Even-lwx/ai8051-esc/SEEKFREE_AI8051U_BLDC/bldc/bldc_version.txt

V2.0.5
	(2026-06-25) 屏蔽掉debug串口，已经串口中断，防止编译报错
	
V2.0.4
	(2026-05-27) 降低频率(40Mhz->35Mhz)
	
V2.0.3
	(2026-05-11) 新增 BLDC_USR_DUTY：可选宏固定占空比，默认 0 仍为外部 PWM 捕获

V2.0.2
	(2026-03-31) PWM频率(48Khz->43.333Khz)，解决干扰20Khz电磁信号源的问题
	
V2.0.1
	(2026-03-25) 增加电调稳定性
	
V2.0.0
	(2026-01-09) 移植STC32G电调代码
