Even-lwx/ai8051-esc/Resource/11.png

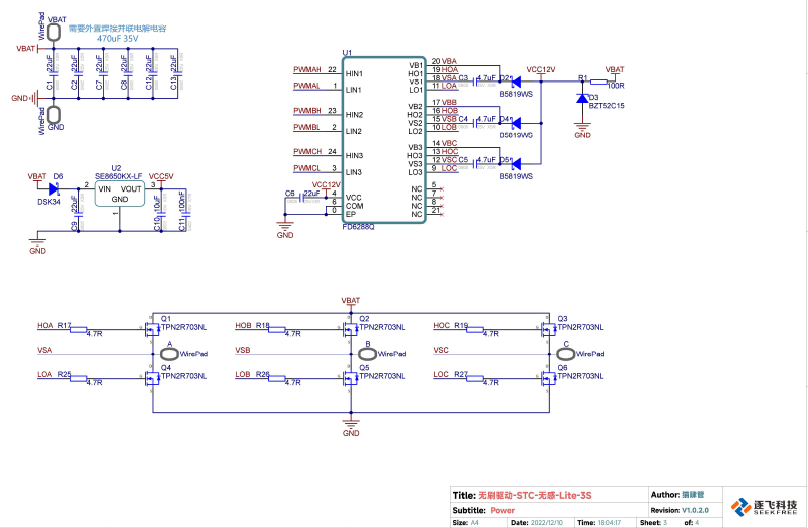
Resource/11.png
