Even-lwx/ai8051-esc/Resource/12.png

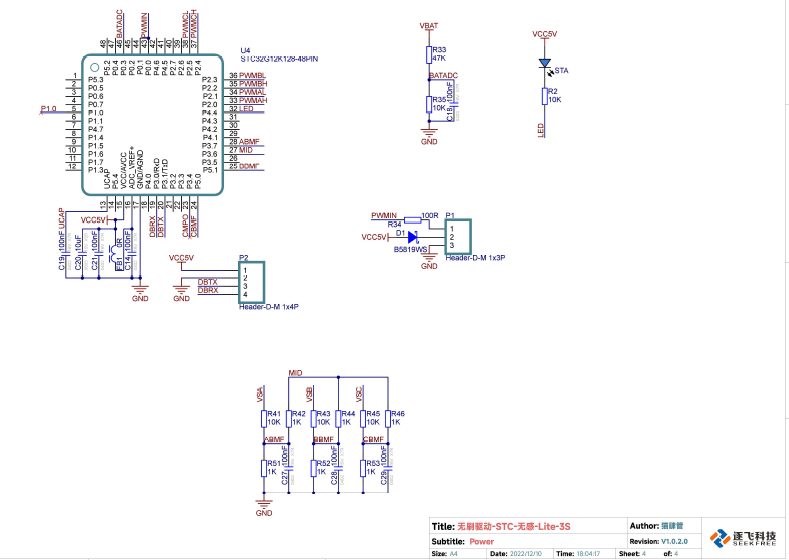
Resource/12.png
