Even-lwx/ai8051-esc/Resource/14.png

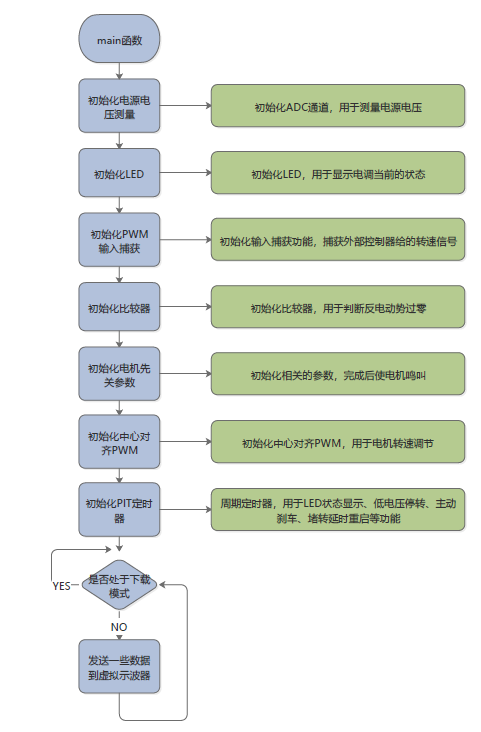
Resource/14.png
