Even-lwx/ai8051-esc/Resource/15.png

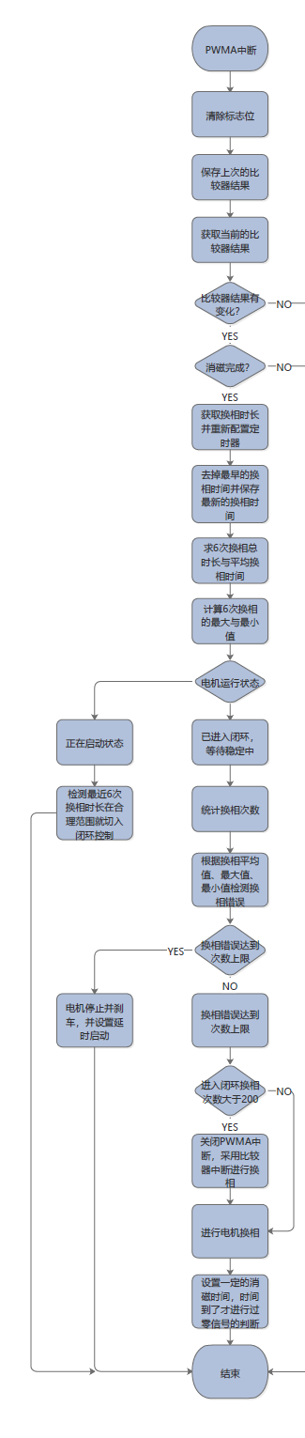
Resource/15.png
