Even-lwx/ai8051-esc/Resource/16.png

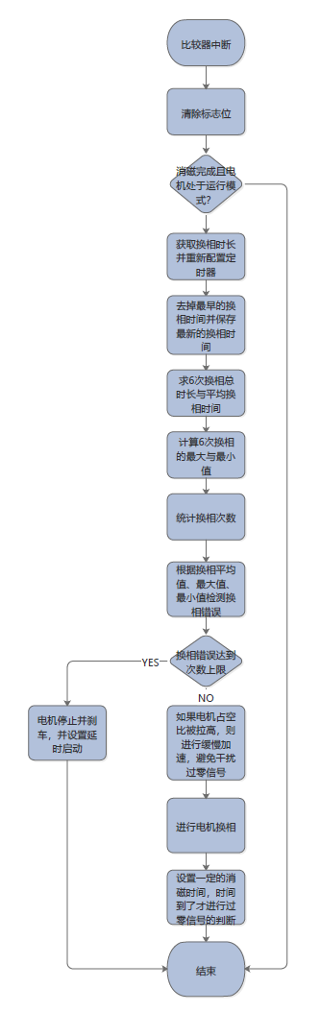
Resource/16.png
