Even-lwx/ai8051-esc/Resource/17.png

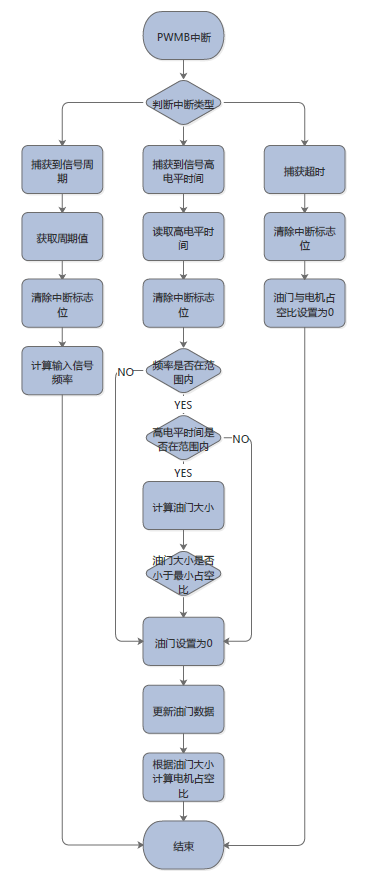
Resource/17.png
