Even-lwx/ai8051-esc/Resource/18.png

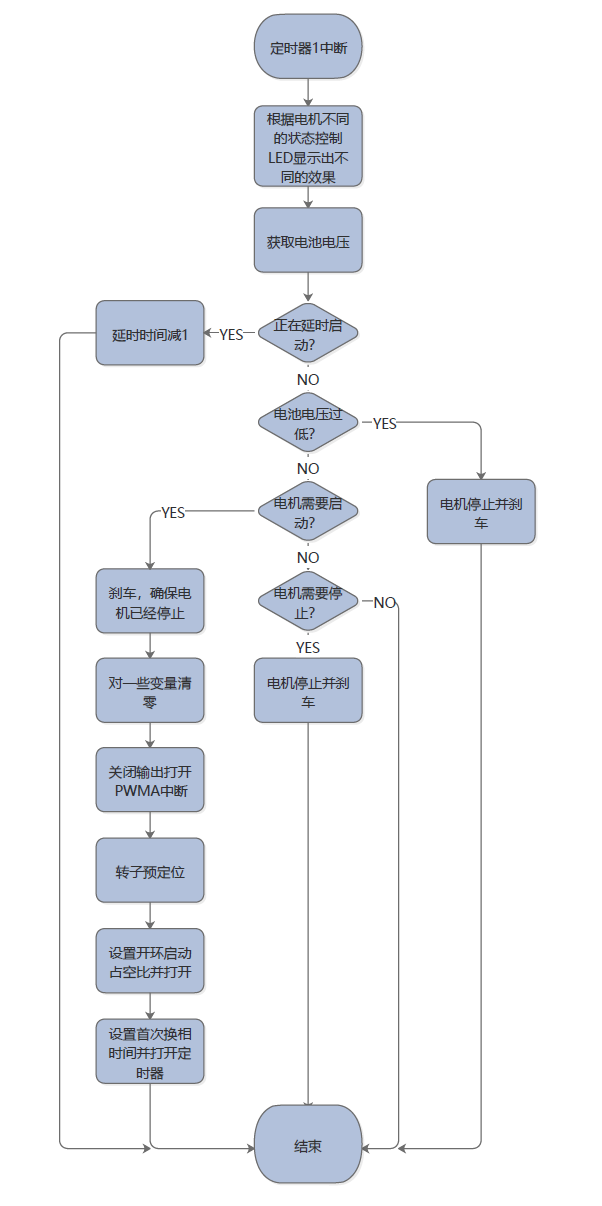
Resource/18.png
