Even-lwx/ai8051-esc/Resource/19.png

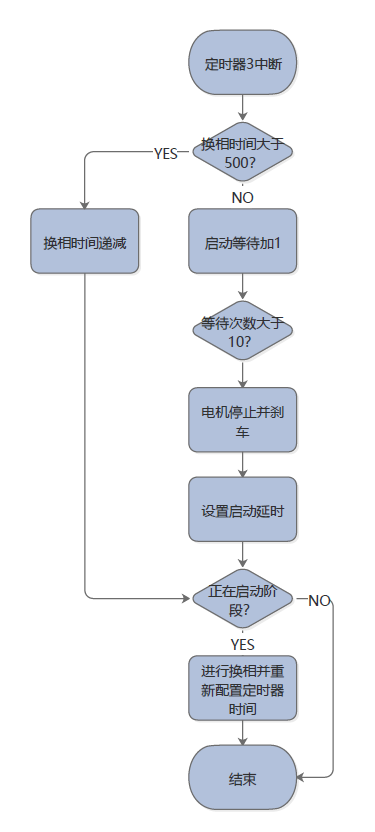
Resource/19.png
