Even-lwx/ai8051-esc/Resource/20.png

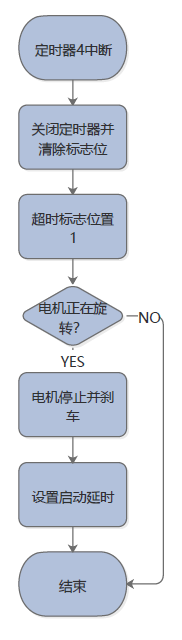
Resource/20.png
