Even-lwx/ai8051-esc/Resource/21.png

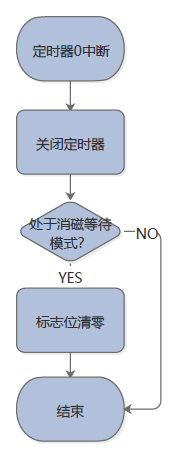
Resource/21.png
