Even-lwx/ai8051-esc/Resource/clip_image002.jpg

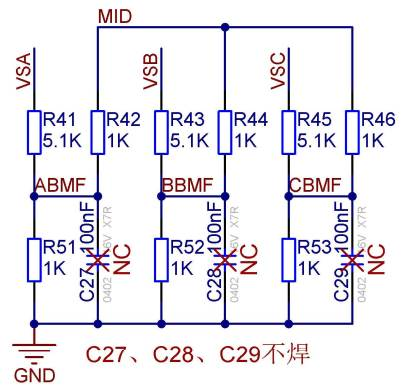
Resource/clip_image002.jpg
