Even-lwx/ai8051-esc/Resource/e8ea1624100522ad72529c74d20f11d.png

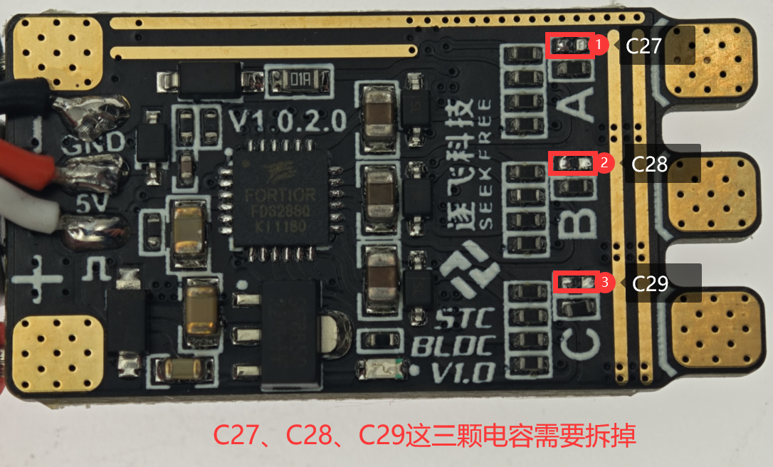
Resource/e8ea1624100522ad72529c74d20f11d.png
