Even-lwx/ai8051-esc/Resource/image-20250102145758415.png

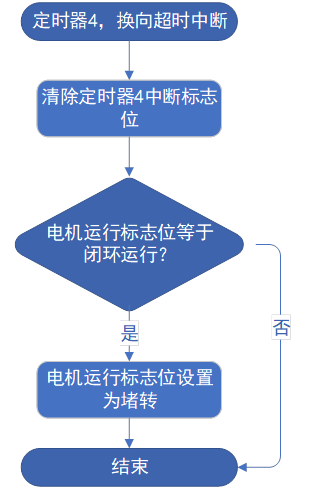
Resource/image-20250102145758415.png
