Even-lwx/ai8051-esc/Resource/image-20250102150058315.png

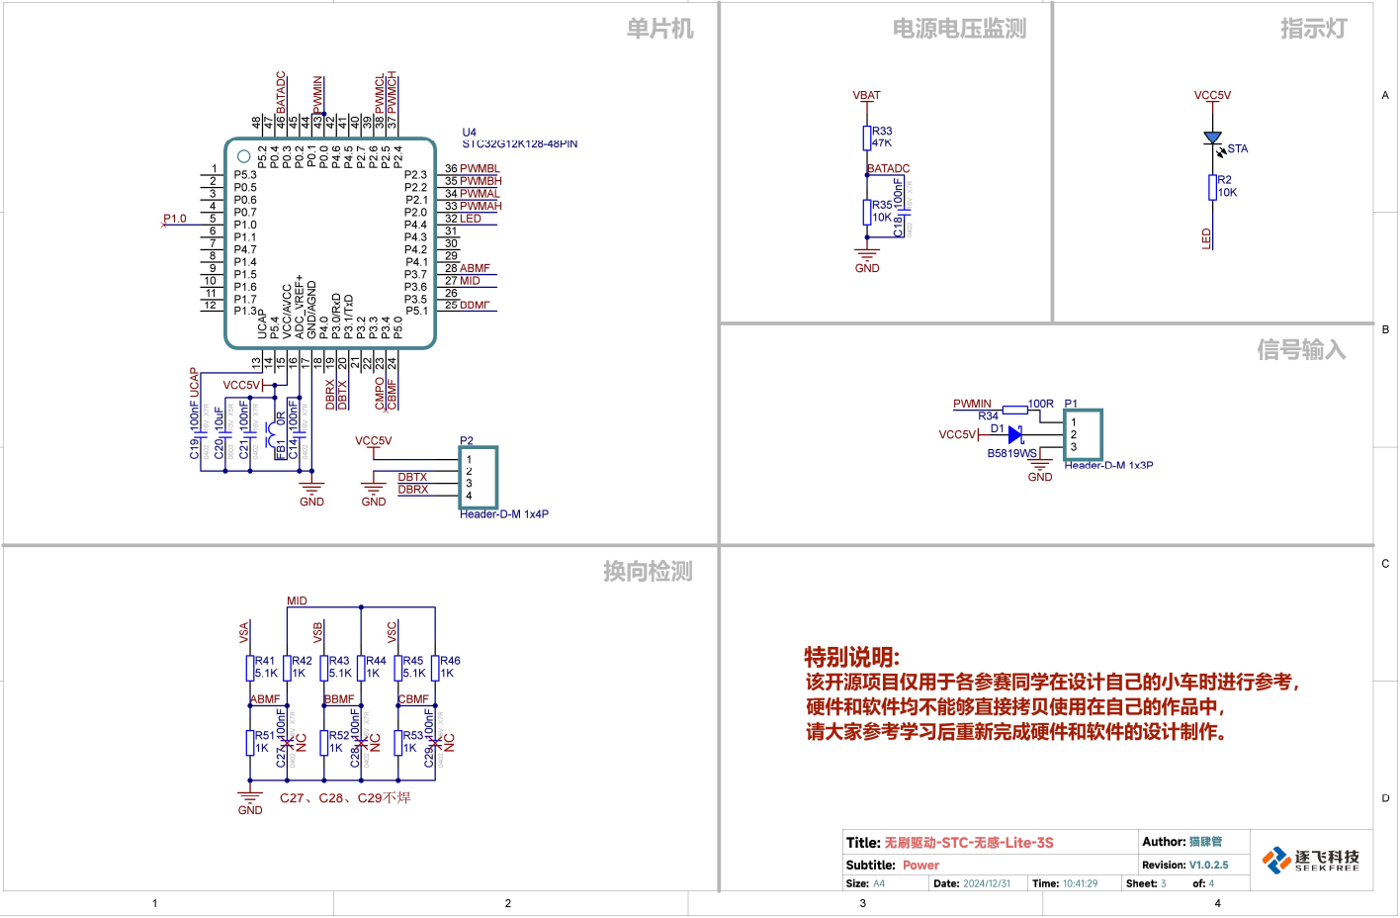
Resource/image-20250102150058315.png
