Even-lwx/ai8051-esc/Resource/image-20250102150125310.png

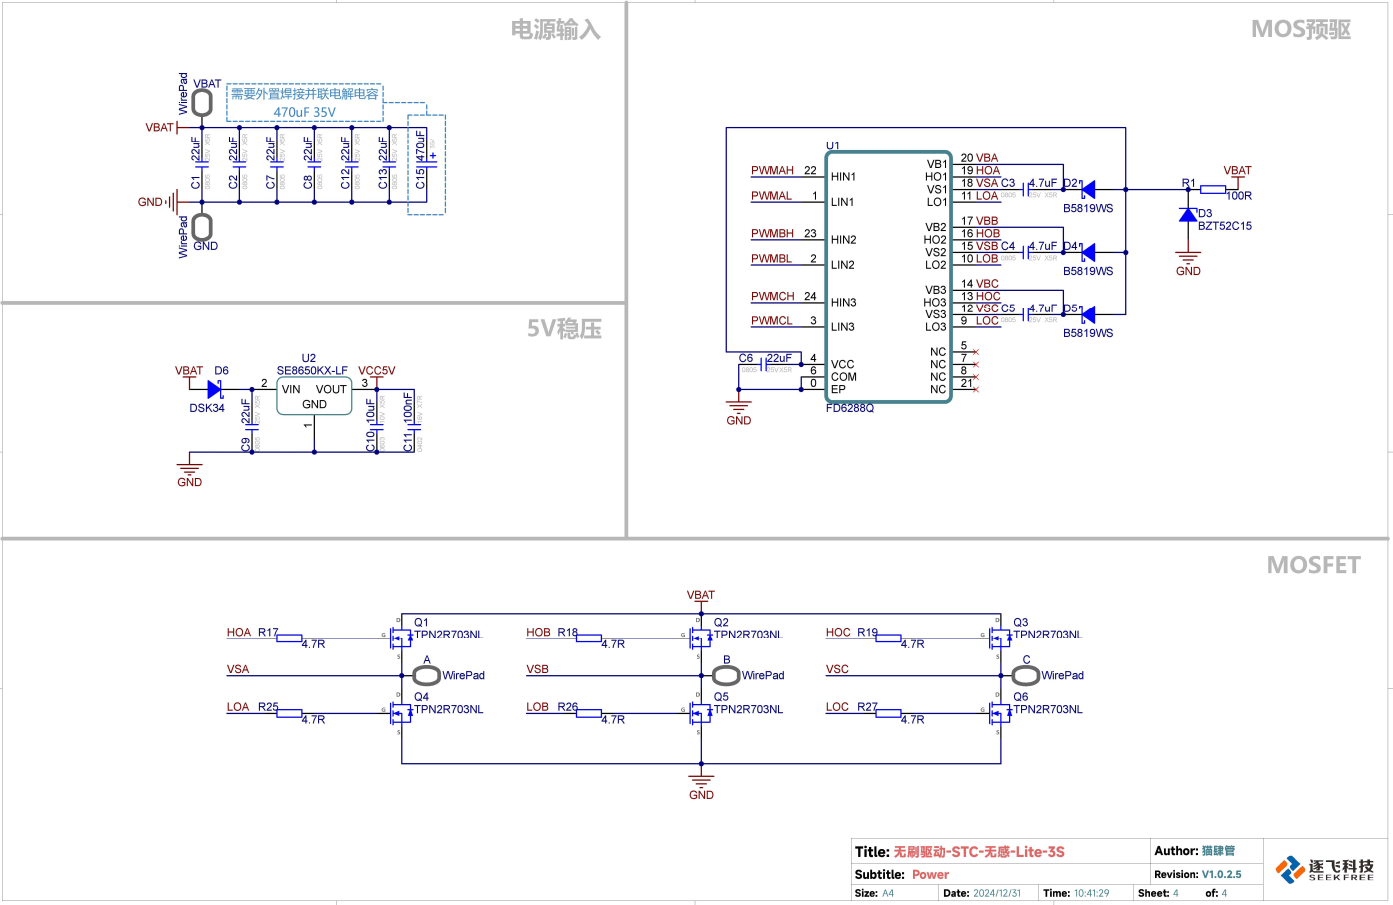
Resource/image-20250102150125310.png
