Even-lwx/ai8051-esc/【文档】说明书 芯片手册 原理图 位号图等/无刷驱动-STC-无感-Lite3S_丝印图 背面_V2.0.2.0.png

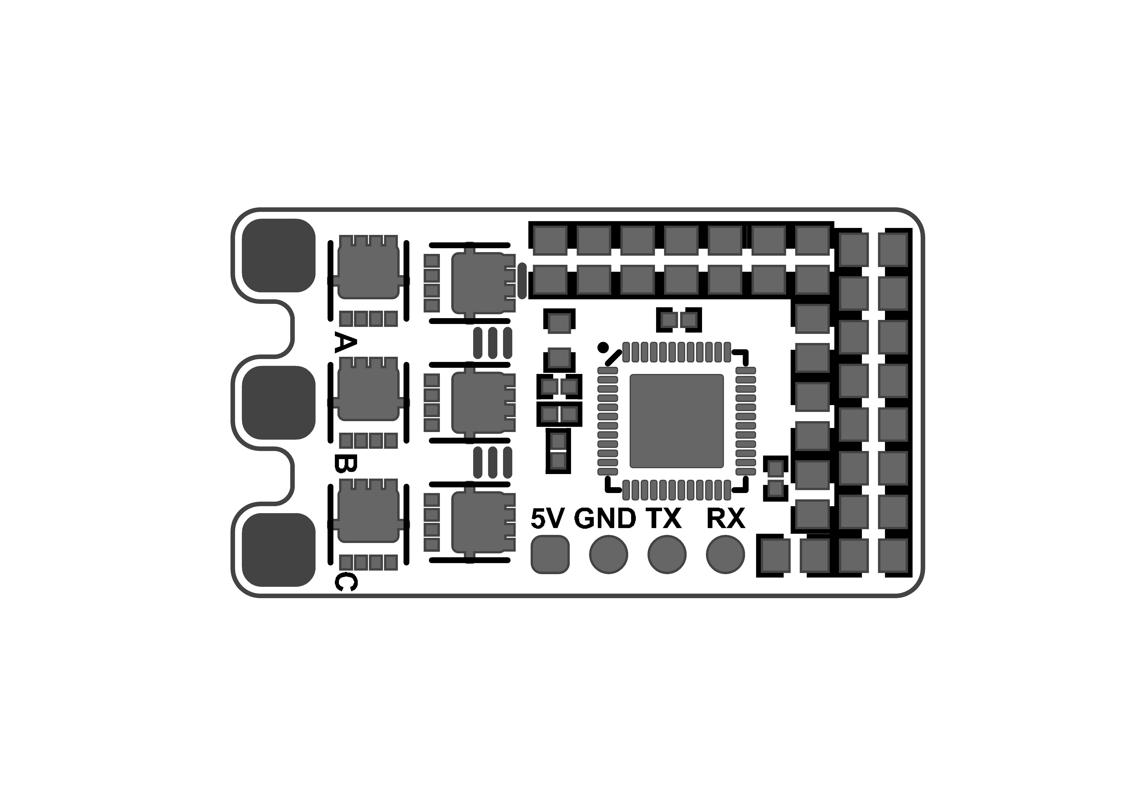
【文档】说明书 芯片手册 原理图 位号图等/无刷驱动-STC-无感-Lite3S_丝印图 背面_V2.0.2.0.png
