Even-lwx/ai8051-esc/已编译好的固件/【必看】下载注意事项.png

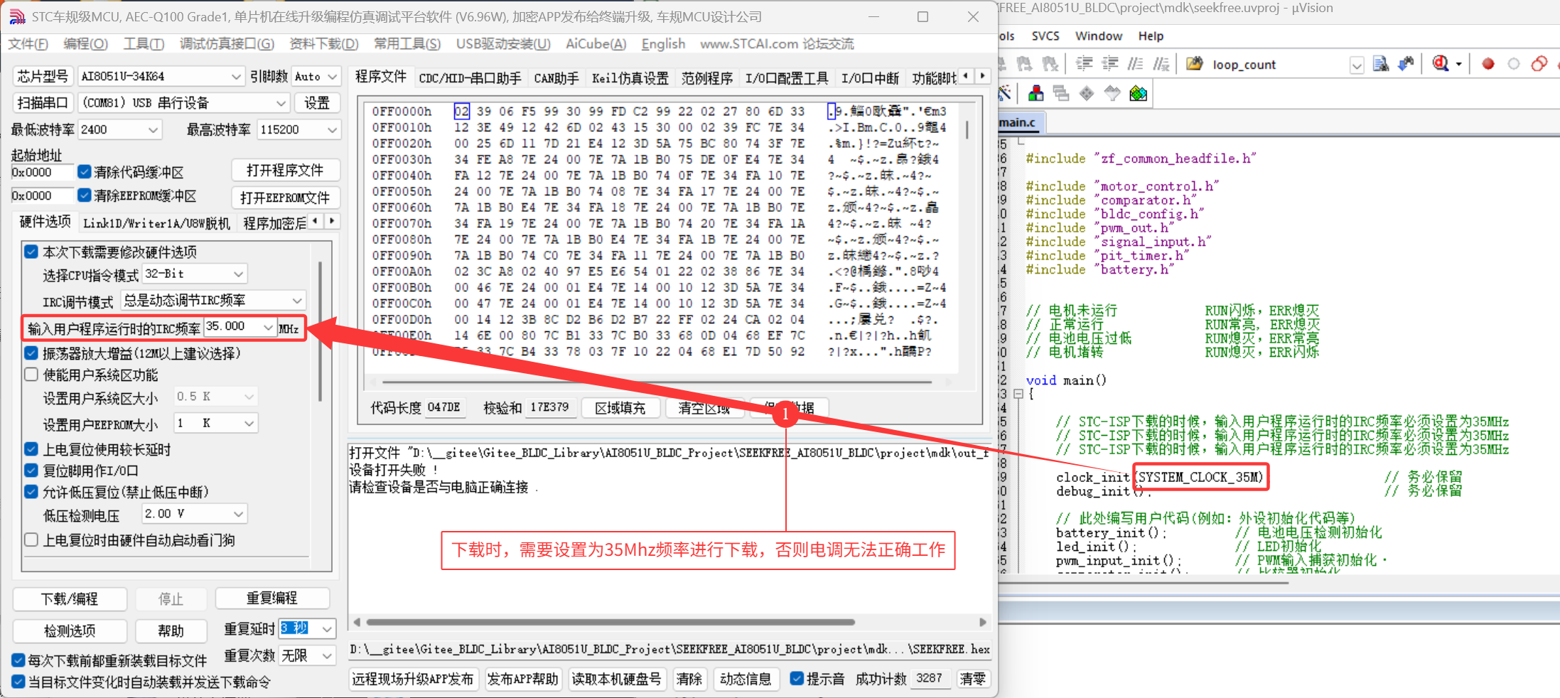
已编译好的固件/【必看】下载注意事项.png
