Even-lwx/ai8051-esc/【文档】说明书 芯片手册 原理图 位号图等/无刷驱动-STC-无感-Lite3S_原理图_V2.0.2.0.pdf

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
无刷驱动-STC-无感-Lite-3S | 贝果
| V2.0.2.0
2026/3/4 | 18:33:26
Title: | Author:

Date:

Revision:
Size: A4 | Time: | Sheet: | of:

### Subtitle: Revision

版本号 | 修订日期 | 修订记录

在此文件中，仅以版本号前两位(发行版)，划分版本之间的区别。

版权所有，保留一切权利。
本公司致力于产品的不断改善和功能升级，内容如有改动，恕不另行通知。
V2.0.0.0 | 2026-01-20 | 芯片改为AI8051U；
| | 改变下载口封装。
| 2026-01-20
| | AI8051U输出的PWM信号接入六个0R电阻到预驱。

添加足够多的贴片电容，不再外接电容；

V1.0.0.0 | 2022-11-13 | 初始版本。
V1.0.1.0 | 2022-11-26 | 删除不必要的逻辑，PWM输入采集换引脚。
V1.0.2.0 | 2022-12-06 | 增加LED，删除测试点，增大焊盘。
V1.0.2.1 | 2023-02-27 | 修改预驱供电网络标号。
V1.0.2.2 | 2024-01-18 | 修改外置的电容符号。
V1.0.2.3 | 2024-03-03 | 修改电容编号小BUG。
V1.0.2.4 | 2024-03-19 | 修改电容编号小BUG。
V1.0.2.5 | 2024-12-31 | 修改采样滤波电容。

V2.0.1.0
修改AI8051U输出的PWM信号引脚；

修改SE8650封装；

V2.0.2.0 | 2026-02-27
删除PWM信号引脚的六个0R电阻。

PWM捕获引脚添加下拉电阻；

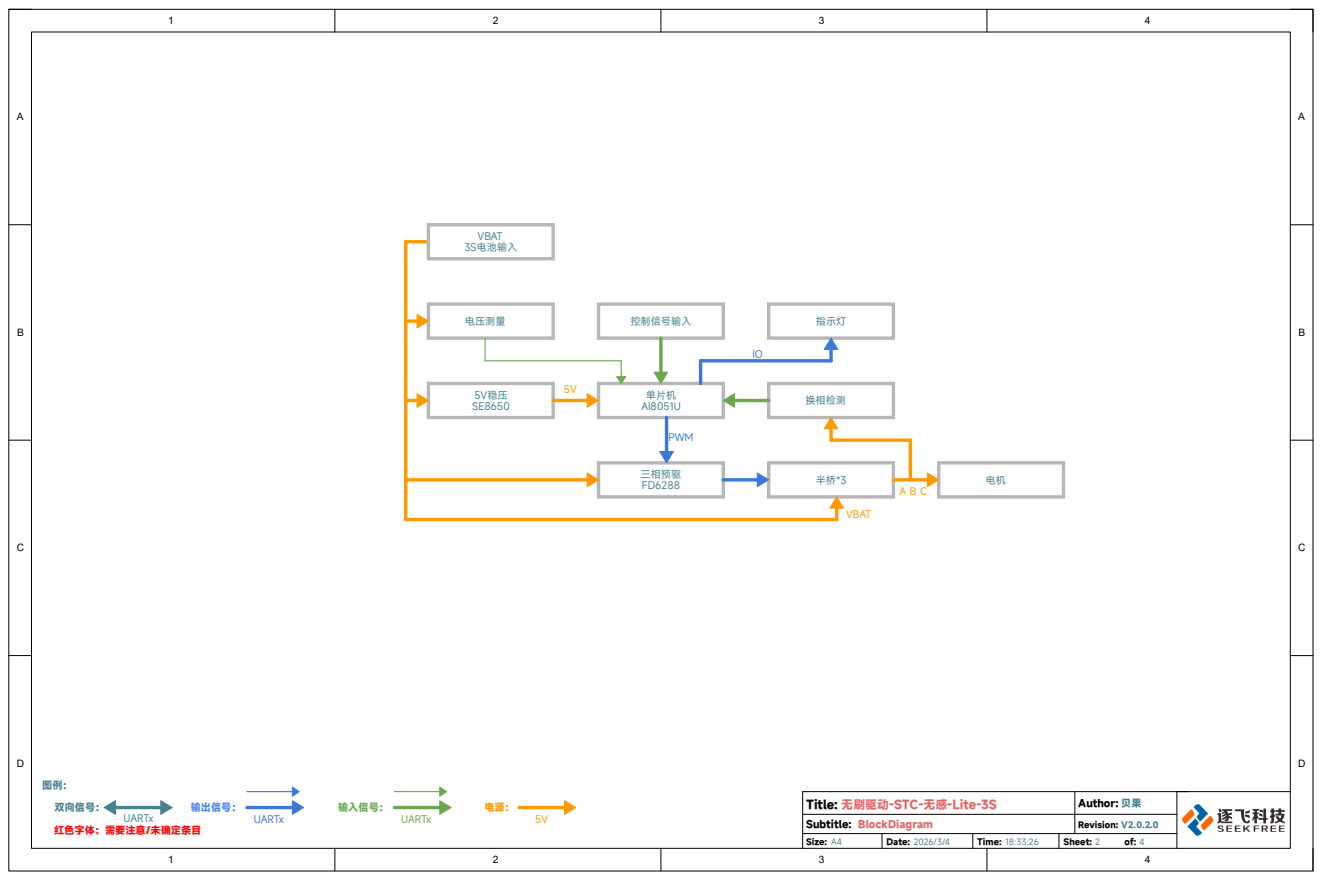
[picture p63: page 2]
无刷驱动-STC-无感-Lite-3S; Title:; Author:; Revision:; Subtitle: BlockDiagram; 双向信号：; 输出信号：; 输入信号：; 红色字体：需要注意/未确定条目; UARTx; 电压测量; 5V稳压; 三相预驱; 单片机; 换相检测; 控制信号输入; PWM; VBAT; VBAT 3S电池输入; 指示灯

电源接口 | 预驱

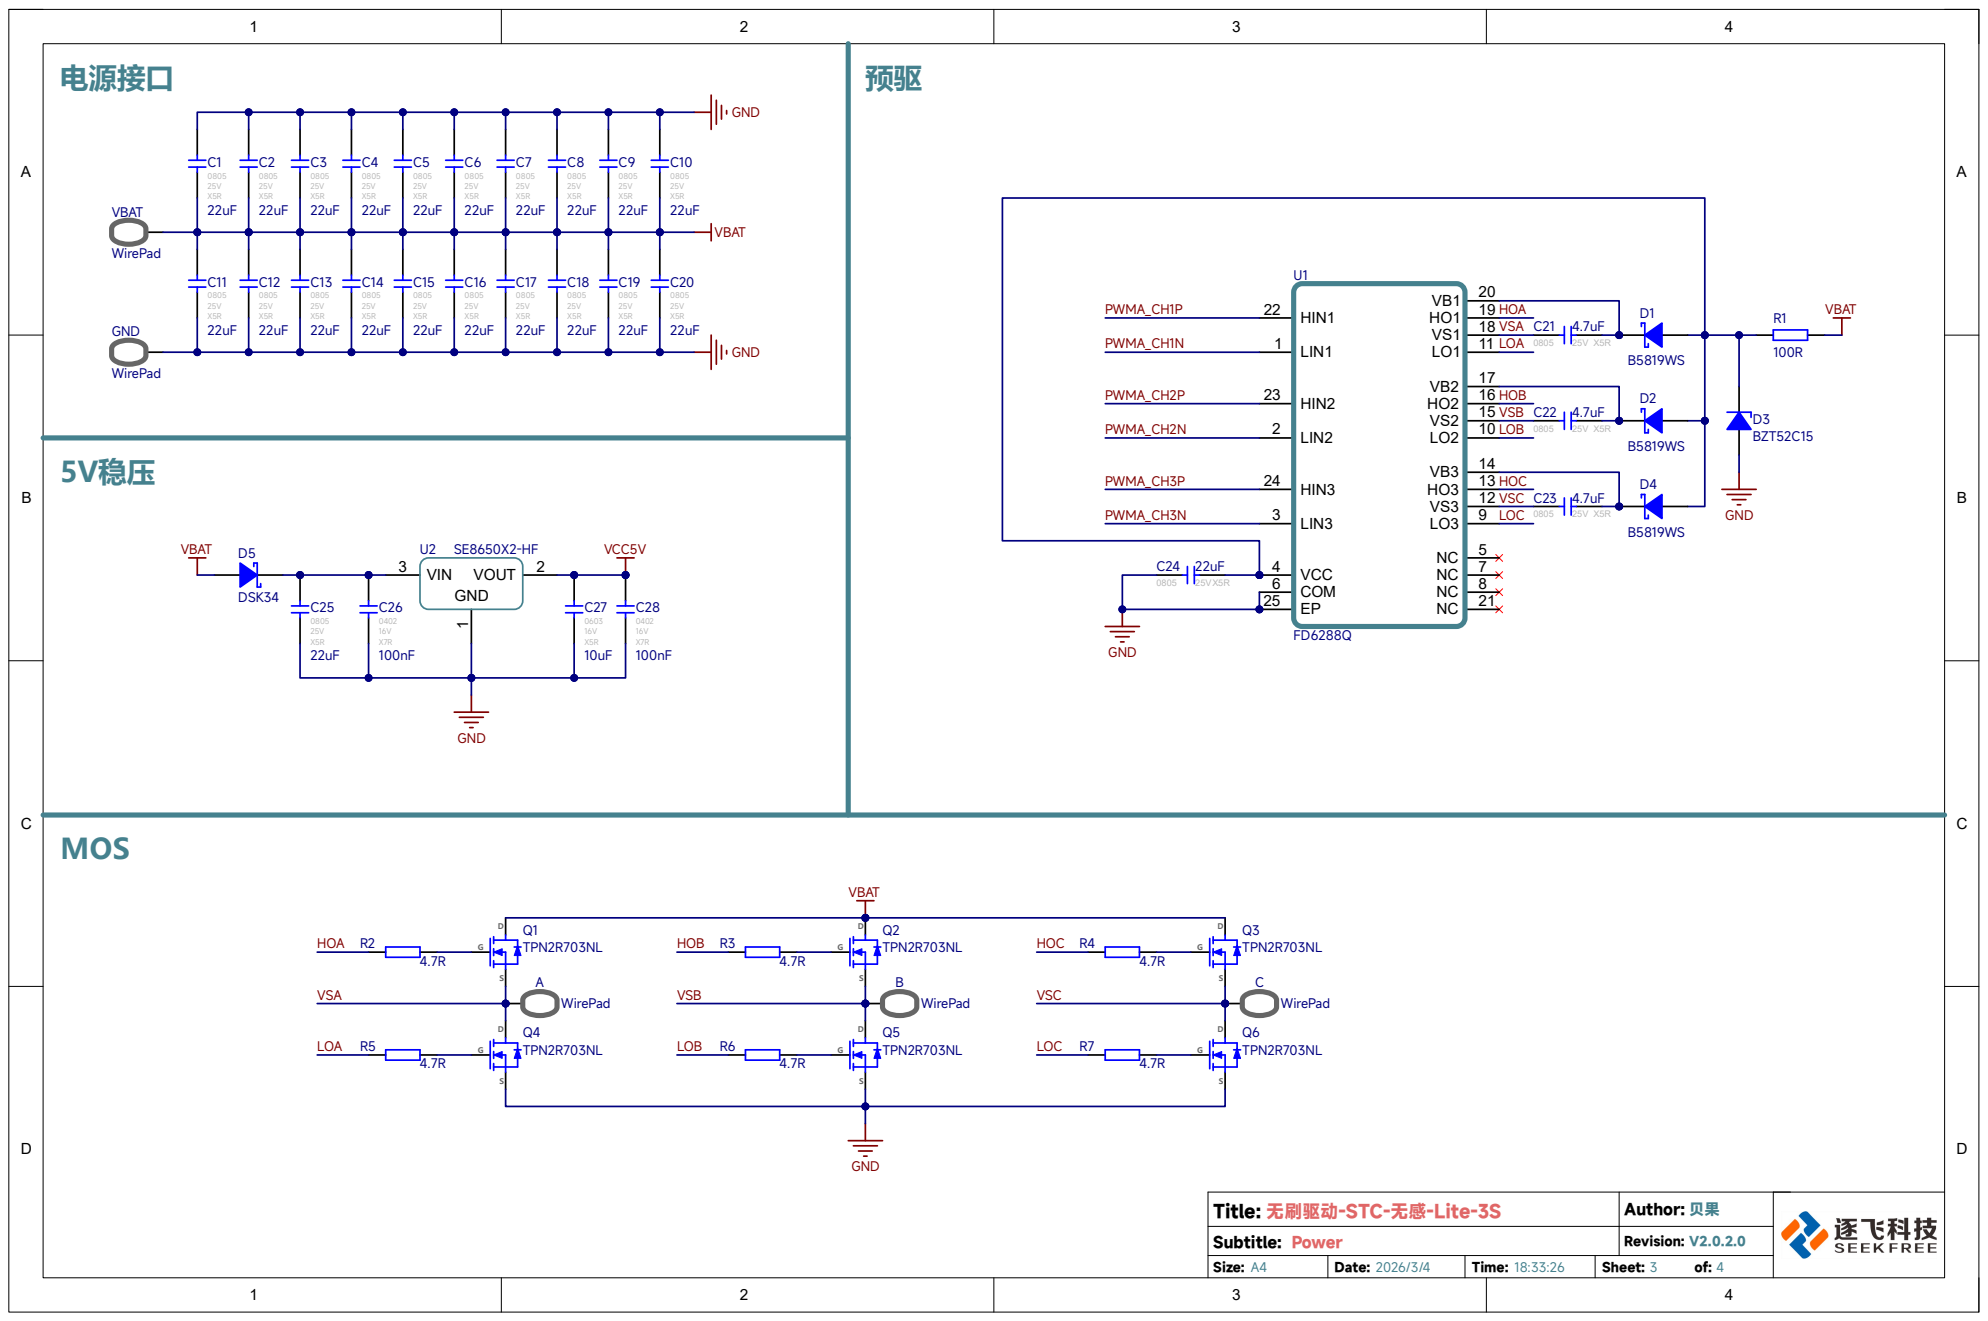
[picture p64: page 3]

# MCU

# 电压检测

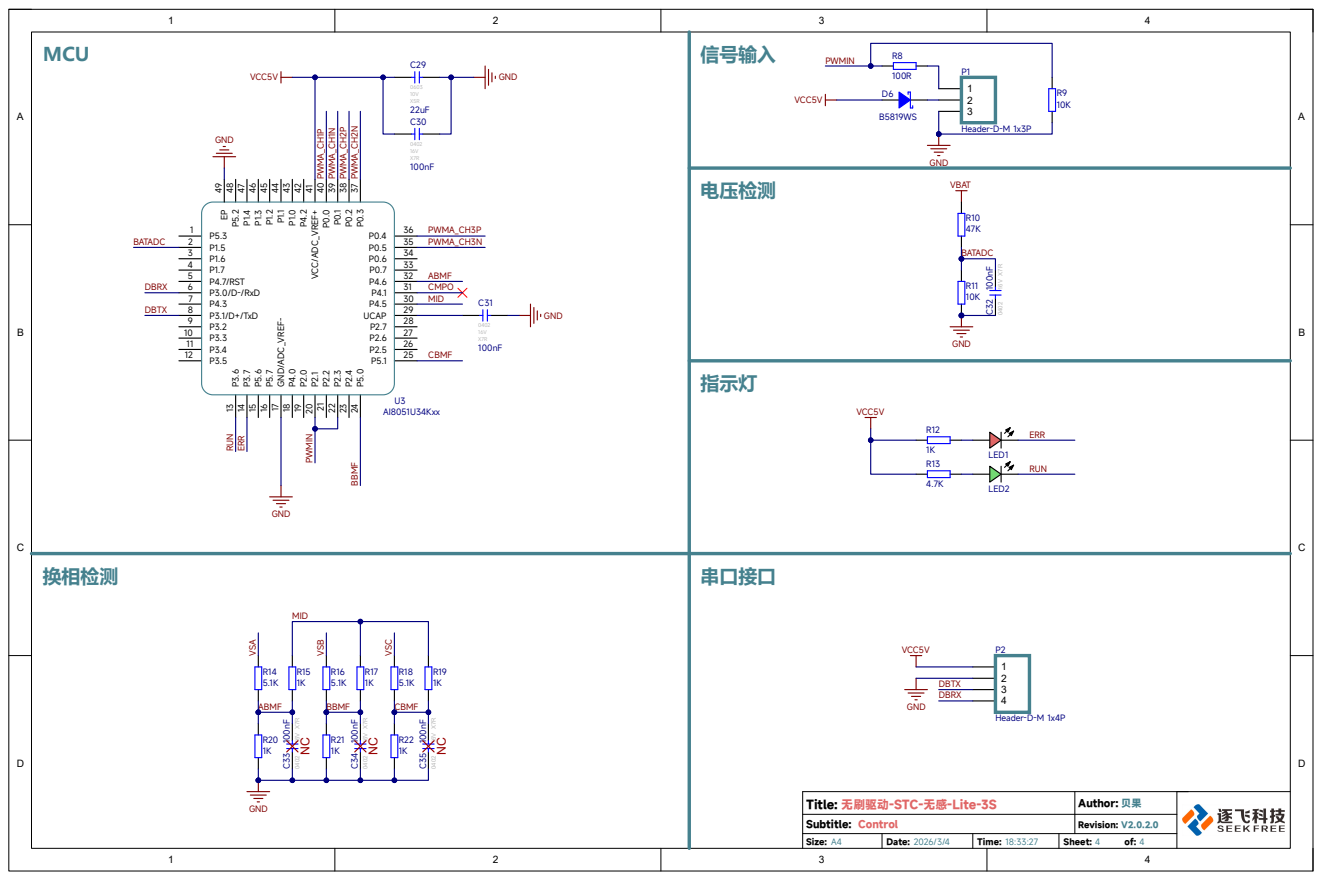
[picture p65: page 4]
