Even-lwx/ai8051-esc/SEEKFREE_AI8051U_BLDC/project/user/main.c

/*********************************************************************************************************************
* AI8051U Opensourec Library 即（AI8051U 开源库）是一个基于官方 SDK 接口的第三方开源库
* Copyright (c) 2022 SEEKFREE 逐飞科技
*
* 本文件是STC 开源库的一部分
*
* AI8051U 开源库 是免费软件
* 您可以根据自由软件基金会发布的 GPL（GNU General Public License，即 GNU通用公共许可证）的条款
* 即 GPL 的第3版（即 GPL3.0）或（您选择的）任何后来的版本，重新发布和/或修改它
*
* 本开源库的发布是希望它能发挥作用，但并未对其作任何的保证
* 甚至没有隐含的适销性或适合特定用途的保证
* 更多细节请参见 GPL
*
* 您应该在收到本开源库的同时收到一份 GPL 的副本
* 如果没有，请参阅<https://www.gnu.org/licenses/>
*
* 额外注明：
* 本开源库使用 GPL3.0 开源许可证协议 以上许可申明为译文版本
* 许可申明英文版在 libraries/doc 文件夹下的 GPL3_permission_statement.txt 文件中
* 许可证副本在 libraries 文件夹下 即该文件夹下的 LICENSE 文件
* 欢迎各位使用并传播本程序 但修改内容时必须保留逐飞科技的版权声明（即本声明）
*
* 文件名称          
* 公司名称          成都逐飞科技有限公司
* 版本信息          查看 libraries/doc 文件夹内 version 文件 版本说明
* 开发环境          MDK FOR C251
* 适用平台          AI8051U
* 店铺链接          https://seekfree.taobao.com/
*
* 修改记录
* 日期              作者           备注
* 2024-08-01        大W            first version
********************************************************************************************************************/

#include "zf_common_headfile.h"

#include "motor_control.h"
#include "comparator.h"
#include "bldc_config.h"
#include "pwm_out.h"
#include "signal_input.h"
#include "pit_timer.h"
#include "battery.h"


// 电机未运行			RUN闪烁，ERR熄灭
// 正常运行           	RUN常亮, ERR熄灭
// 电池电压过低       	RUN熄灭，ERR常亮
// 电机堵转        		RUN熄灭，ERR闪烁

void main()
{
        
    // STC-ISP下载的时候，输入用户程序运行时的IRC频率必须设置为35MHz
    // STC-ISP下载的时候，输入用户程序运行时的IRC频率必须设置为35MHz
    // STC-ISP下载的时候，输入用户程序运行时的IRC频率必须设置为35MHz
        
    clock_init(SYSTEM_CLOCK_35M);				// 务必保留

    // 此处编写用户代码(例如：外设初始化代码等)
    //battery_init();         // 电池电压检测初始化
    led_init();             // LED初始化
    pwm_input_init();       // PWM输入捕获初始化·
    comparator_init();      // 比较器初始化 
    motor_init();           // 电机相关初始化 

    // PWM初始化务必放在电机电机初始化函数之后，否则会烧毁电机
    // PWM初始化务必放在电机电机初始化函数之后，否则会烧毁电机
    // PWM初始化务必放在电机电机初始化函数之后，否则会烧毁电机
    pwm_out_init();      	// PWM初始化 采用中心对齐       

	pit_timer_init();       // 周期定时器初始化
    

    EA = 1;                 // 开启总中断

            
    while(1)
	{

    }
}
