Even-lwx/ai8051-esc/(commit log)

2026-03-20 V2.0.0 (2026-01-02) 从STC32G电调移植到AI8051U
2026-03-20 删掉多余文件夹
2026-03-30 V2.0.1 (2026-03-25) 增加电调稳定性
2026-03-31 V2.0.2 (2026-03-31) PWM频率(48Khz->43.333Khz)，解决干扰20Khz电磁信号源的问题
2026-05-12 V2.0.3 (2026-05-11) 新增 BLDC_USR_DUTY：可选宏固定占空比，默认 0 仍为外部 PWM 捕获
2026-06-02 V2.0.4 (2026-05-27) 降低频率(40Mhz->35Mhz)
2026-06-09 添加【必看】下载注意事项.png
2026-06-09 更新电调说明书
2026-06-25 V2.0.5 (2026-06-25) 屏蔽掉debug串口，已经串口中断，防止编译报错
2026-08-07 1.关闭电压检测 2.将400hz上限改到500hz上限
2026-08-07 使能互补输出
2026-08-17 禁用换相超时、堵转及输入失联自动停机
    - 增加 BLDC_ENABLE_PROTECTION 总开关并默认关闭
    - 禁用 Timer4 闭环换相长期未完成触发的堵转停机
    - 禁用 Timer0 换相时间异常累计超限触发的停机
    - 禁用开环阶段约 100ms 未检测到有效过零信号触发的堵转停机
    - 禁用闭环阶段比较器状态约 100ms 无变化触发的堵转停机
    - 禁用 PWM 输入失联后自动清零油门
    - 非法频率及小于 1000us、超过 3000us 的 PWM 帧保持上次有效油门
    - 增加 PWM 周期为零时的除零保护
    - 保留 1000～1049us 明确零油门的正常停机
