Even-lwx/ai8051-esc/(notices)

Notices in the files:
SEEKFREE_AI8051U_BLDC/bldc/bldc_config.h:
Copyright (c) 2020,Öð·É¿Æ¼¼
All rights reserved.
SEEKFREE_AI8051U_BLDC/project/user/isr.c:
Copyright (c) 2022 SEEKFREE Öð·É¿Æ¼¼
